znibb/ThreeMan_HW/README.md

# ThreeMan_HW

## Description
PCB design for the ThreeMan dice game (see [ThreeMan](https://github.com/znibb/ThreeMan)).

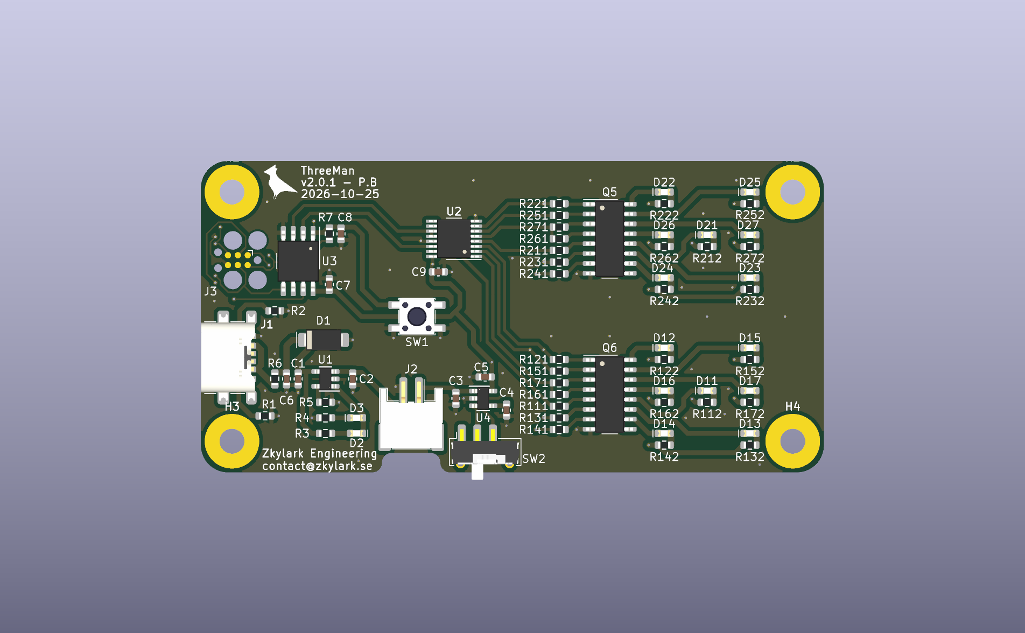
[picture p1: img/PCB_Render_Top.png]
Top
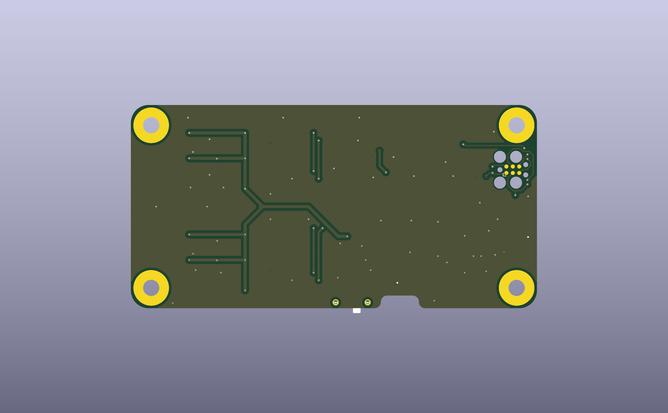
[picture p2: img/PCB_Render_Bottom.png]
Bottom
|  |  |
| --- | --- |

## Changelog
The format is based on [Keep a Changelog](https://keepachangelog.com/).  

According to Hardware Semantic Versioning (MAJOR.MINOR.PATCH), increment:
* MAJOR - when changing mechanical or connector interfaces
* MINOR - when changing schematic or layout
* PATCH - when changing BOM or sourcing data

All notable changes to this PCB project will be documented in [CHANGELOG.md](CHANGELOG.md).
