znibb/ThreeMan_HW/ThreeMan_HW.kicad_pcb

## KiCad design ThreeMan_HW.kicad_pcb (2026-10-25)

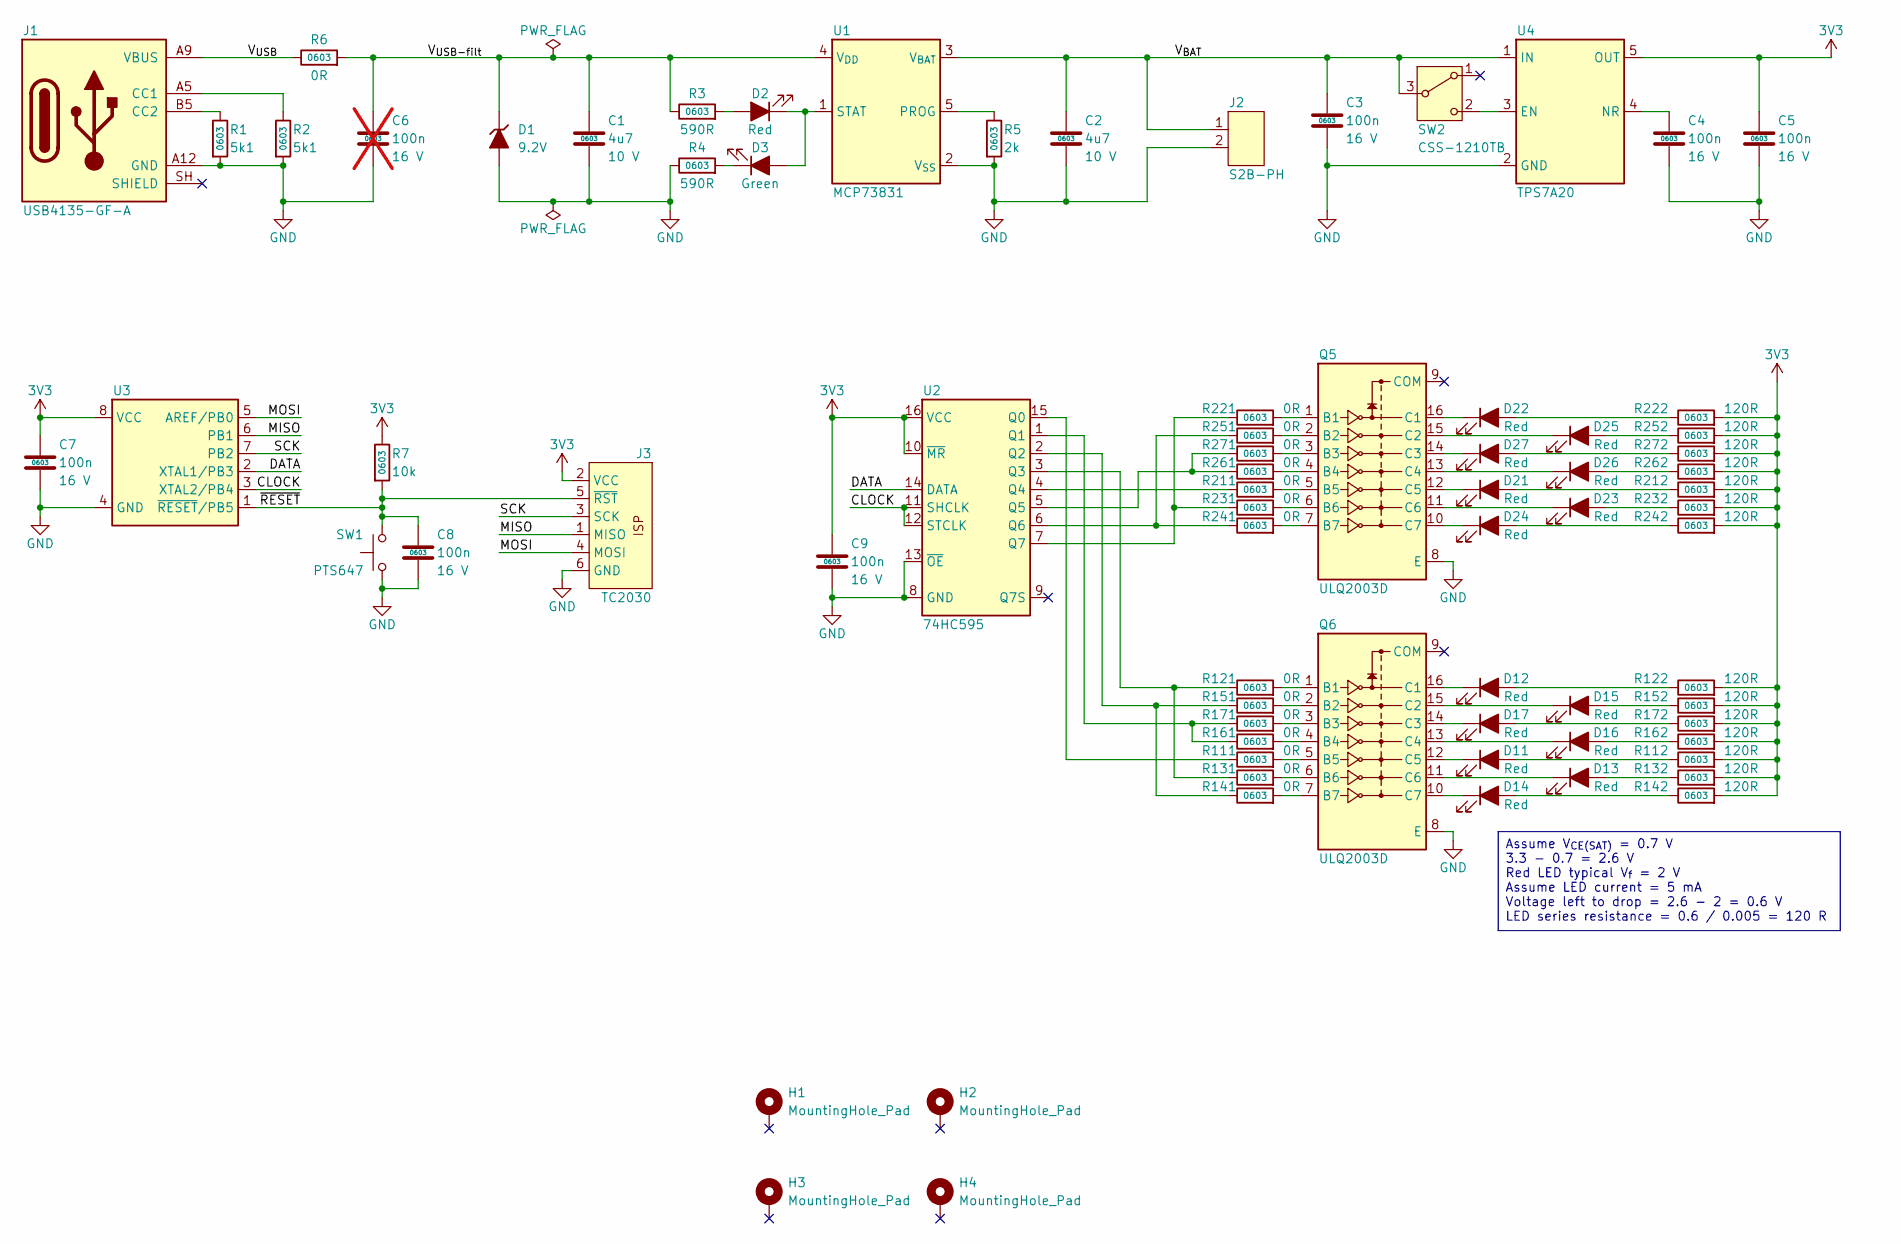
[picture p3: schematic ThreeMan_HW.kicad_sch, ${PROJECT_NAME}]

Parts:
C1, C2: 4u7; C_0603_1608Metric; VoltageRating 10 V; Tolerance 20 %; MPN CC0603MRX5R6BB475
C3, C4, C5, C7, C8, C9: 100n; C_0603_1608Metric; VoltageRating 16 V; Tolerance 10 %; MPN CC0603KRX7R7BB104
C6: 100n; C_0603_1608Metric; VoltageRating 16 V; Tolerance 10 %; MPN CC0603KRX7R7BB104; not fitted
D1: 9.2V; D_SMA; VoltageBreakdown 6.4 V; VoltageClamping 9.2 V; MPN SMAJ5.0A
D2, D11, D12, D13, D14, D15, D16, D17, D21, D22, D23, D24, D25, D26, D27: LTST-C191KRKT; LED_0603_1608Metric; VoltageForward 2 V; MPN LTST-C191KRKT
D3: LTST-C190KGKT[A; LED_0603_1608Metric; VoltageForward 2.1 V; MPN LTST-C190KGKT[A
H1, H2, H3, H4: MountingHole_Pad; MountingHole_3.2mm_Pad
J1: USB4135-GF-A; GCT-USB4135-GF-A; VoltageRating 48 V; MPN USB4135-GF-A
J2: S2B-PH; JST_PH_B2B-PH-SM4-TB_1x02-1MP_P2.00mm_Vertical; MPN S2B-PH-SM4-TB
J3: TC2030; TagConnect_TC2030_2x3_DualSide
Q5, Q6: ULQ2003D; SOIC-16_3.9x9.9mm_P1.27mm; VoltageCollectorEmitter 50 V; MPN ULQ2003D1013TRY
R1, R2: 5k1; R_0603_1608Metric; Tolerance 1 %; MPN RC0603FR-075K1L
R3, R4: 590R; R_0603_1608Metric; Tolerance 1 %; MPN RC0603FR-13590RL
R5: 2k; R_0603_1608Metric; Tolerance 1 %; MPN RC0603FR-102KL
R6, R111, R121, R131, R141, R151, R161, R171, R211, R221, R231, R241, R251, R261, R271: 0R; R_0603_1608Metric; Tolerance %; MPN RC0603JR-070RL
R7: 10k; R_0603_1608Metric; Tolerance 1 %; MPN RC0603FR-0710KL
R112, R122, R132, R142, R152, R162, R172, R212, R222, R232, R242, R252, R262, R272: 120R; R_0603_1608Metric; Tolerance 1 %; MPN RC0603FR-07120RL
SW1: PTS647; SW_Push_SPST_4.5x4.5mm_H7.0mm; VoltageRating 12 V; MPN PTS647SM70SMTR2 LFS
SW2: CSS-1210TB; VoltageRating 12 V; MPN CSS-1210TB
U1: MCP73831; SOT-23-5; MPN MCP73831T-2ACI-OT
U2: 74HC595; TSSOP-16_4.4x5mm_P0.65mm; MPN 74HC595PW,118
U3: ATTINY85; SOIC-8_5.3x5.3mm_P1.27mm; MPN ATTINY85-20SUR
U4: TPS7A20; SOT-23-5; MPN TPS7A2033PDBVR

Connections:
/3V3: C5.1, C7.1, C9.1, J3.2 (VCC), R7.1, R112.2, R122.2, R132.2, R142.2, R152.2, R162.2, R172.2, R212.2, R222.2, R232.2, R242.2, R252.2, R262.2, R272.2, U2.10 (~MR), U2.16 (VCC), U3.8 (VCC), U4.5 (OUT)
/CLOCK: U2.11 (SHCLK), U2.12 (STCLK), U3.3 (XTAL2/PB4)
/DATA: U2.14 (DATA), U3.2 (XTAL1/PB3)
/GND: C1.2, C2.2, C3.2, C4.2, C5.2, C6.2, C7.2, C8.2, C9.2, D1.2, J1.A12 (GND), J1.B12 (GND), J2.2, J3.6 (GND), Q5.8 (E), Q6.8 (E), R1.2, R2.2, R4.1, R5.2, SW1.1, U1.2 (V_{SS}), U2.8 (GND), U2.13 (~OE), U3.4 (GND), U4.2 (GND)
/MISO: J3.1 (MISO), U3.6 (PB1)
/MOSI: J3.4 (MOSI), U3.5 (AREF/PB0)
/SCK: J3.3 (SCK), U3.7 (PB2)
/V_{BAT}: C2.1, C3.1, J2.1, SW2.3 (B), U1.3 (V_{BAT}), U4.1 (IN)
/V_{USB-filt}: C1.1, C6.1, D1.1, R3.1, R6.2, U1.4 (V_{DD})
/V_{USB}: J1.A9 (VBUS), J1.B9 (VBUS), R6.1
/~RESET: C8.1, J3.5 (~RST), R7.2, SW1.2, U3.1 (~RESET/PB5)
unnamed: D2.A, R3.2
unnamed: D3.C, R4.2
unnamed: D11.A, R112.1
unnamed: D12.A, R122.1
unnamed: D13.A, R132.1
unnamed: D14.A, R142.1
unnamed: D15.A, R152.1
unnamed: D16.A, R162.1
unnamed: D17.A, R172.1
unnamed: D21.A, R212.1
unnamed: D22.A, R222.1
unnamed: D23.A, R232.1
unnamed: D24.A, R242.1
unnamed: D25.A, R252.1
unnamed: D26.A, R262.1
unnamed: D27.A, R272.1
unnamed: J1.A5 (CC1), R2.1
unnamed: J1.B5 (CC2), R1.1
unnamed: Q5.1 (B1), R221.2
unnamed: Q5.2 (B2), R251.2
unnamed: Q5.3 (B3), R271.2
unnamed: Q5.4 (B4), R261.2
unnamed: Q5.5 (B5), R211.2
unnamed: Q5.6 (B6), R231.2
unnamed: Q5.7 (B7), R241.2
unnamed: D22.C, Q5.16 (C1)
unnamed: D25.C, Q5.15 (C2)
unnamed: D27.C, Q5.14 (C3)
unnamed: D26.C, Q5.13 (C4)
unnamed: D21.C, Q5.12 (C5)
unnamed: D23.C, Q5.11 (C6)
unnamed: D24.C, Q5.10 (C7)
unnamed: Q6.1 (B1), R121.2
unnamed: Q6.2 (B2), R151.2
unnamed: Q6.3 (B3), R171.2
unnamed: Q6.4 (B4), R161.2
unnamed: Q6.5 (B5), R111.2
unnamed: Q6.6 (B6), R131.2
unnamed: Q6.7 (B7), R141.2
unnamed: D12.C, Q6.16 (C1)
unnamed: D15.C, Q6.15 (C2)
unnamed: D17.C, Q6.14 (C3)
unnamed: D16.C, Q6.13 (C4)
unnamed: D11.C, Q6.12 (C5)
unnamed: D13.C, Q6.11 (C6)
unnamed: D14.C, Q6.10 (C7)
unnamed: SW2.2 (C), U4.3 (EN)
unnamed: R5.1, U1.5 (PROG)
unnamed: D2.C, D3.A, U1.1 (STAT)
unnamed: R111.1, U2.15 (Q0)
unnamed: R161.1, R171.1, U2.1 (Q1)
unnamed: R141.1, R151.1, U2.2 (Q2)
unnamed: R121.1, R131.1, U2.3 (Q3)
unnamed: R211.1, U2.4 (Q4)
unnamed: R261.1, R271.1, U2.5 (Q5)
unnamed: R241.1, R251.1, U2.6 (Q6)
unnamed: R221.1, R231.1, U2.7 (Q7)
unnamed: C4.1, U4.4 (NR)

Notes on the sheet:
Assume V_{CE(SAT)} = 0.7 V 3.3 - 0.7 = 2.6 V Red LED typical V_{f} = 2 V Assume LED current = 5 mA Voltage left to drop = 2.6 - 2 = 0.6 V LED series resistance = 0.6 / 0.005 = 120 R

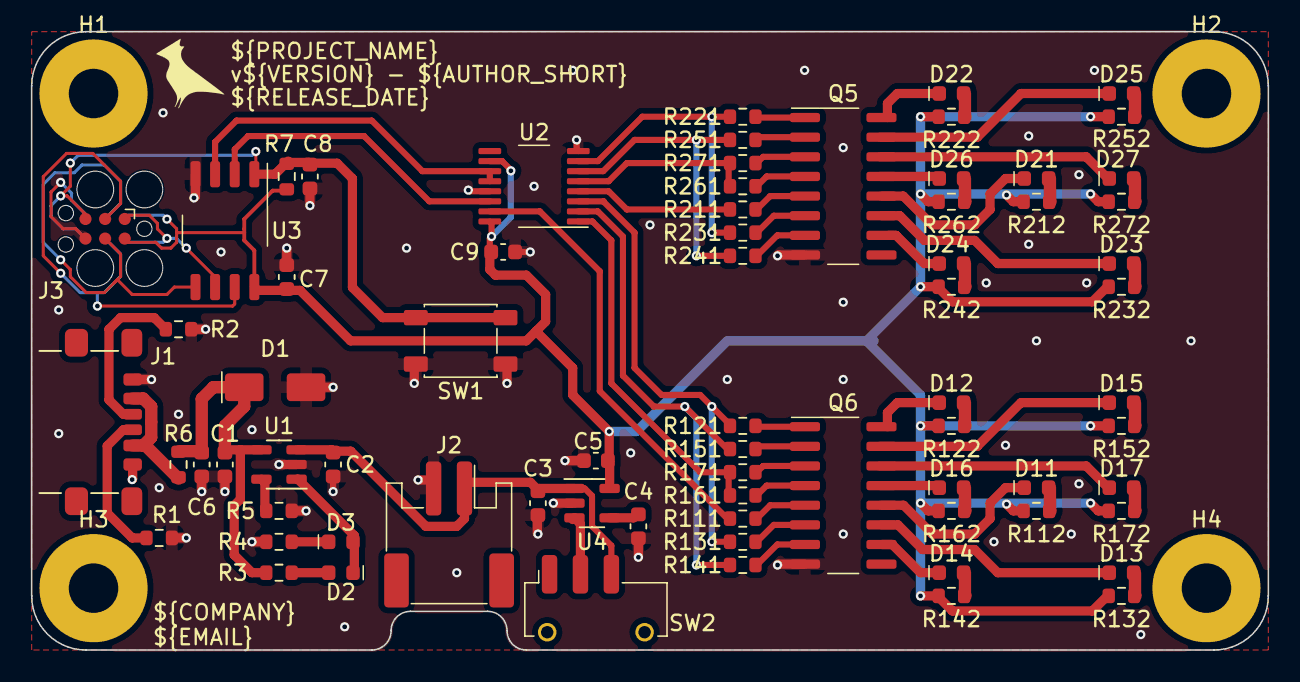
[picture p4: board ThreeMan_HW.kicad_pcb from above]

Board: 4 copper layers, 80.0 x 40.0 mm, 76 parts (0 on the bottom side), 69 nets.
