znibb/ThreeMan_HW/CHANGELOG.md

# CHANGELOG

<!-- ## template
Released: YYYY-MM-DD
### Added
### Changed
### Fixed
### Removed -->

## v2.0.1
Released: 2026-10-25
### Added
1. JLCPCB PCB ordering information to PCB.Comments output

## v2.0.0
Released: 2026-10-24
### Added
1. More detailed silkscreen info
2. Drawing sheet
### Changed
1. Ported all components to zpklib
2. TagConnect connector pinout to work directly with AVRISPmkII

## v1.0.0 (A1)
Released: 2025-05-20
### Added
1. Initial release
