znibb/ThreeMan_HW/(commit log)

2024-08-26 Imported updated schematic drawing
    [ThreeMan_HW.kicad_sch]
2024-08-27 Finished initial draft of A1 schematic and imported it to PCB
    [ThreeMan_HW.kicad_pcb, ThreeMan_HW.kicad_sch]
2025-05-20 Completed layout
    [ThreeMan_HW.kicad_pcb, ThreeMan_HW.kicad_sch]
2026-10-24 Added JLCPCB PCB ordering information to PCB.Comments
2026-10-25 Fixed missaligned schematic component labels
2026-10-25 Added button position dimensions to Drawing layer
